Woz4tetra/dodobot-pcb/Dodobot/Dodobot.brd

## EAGLE design Dodobot/Dodobot.brd (2020-08-03)

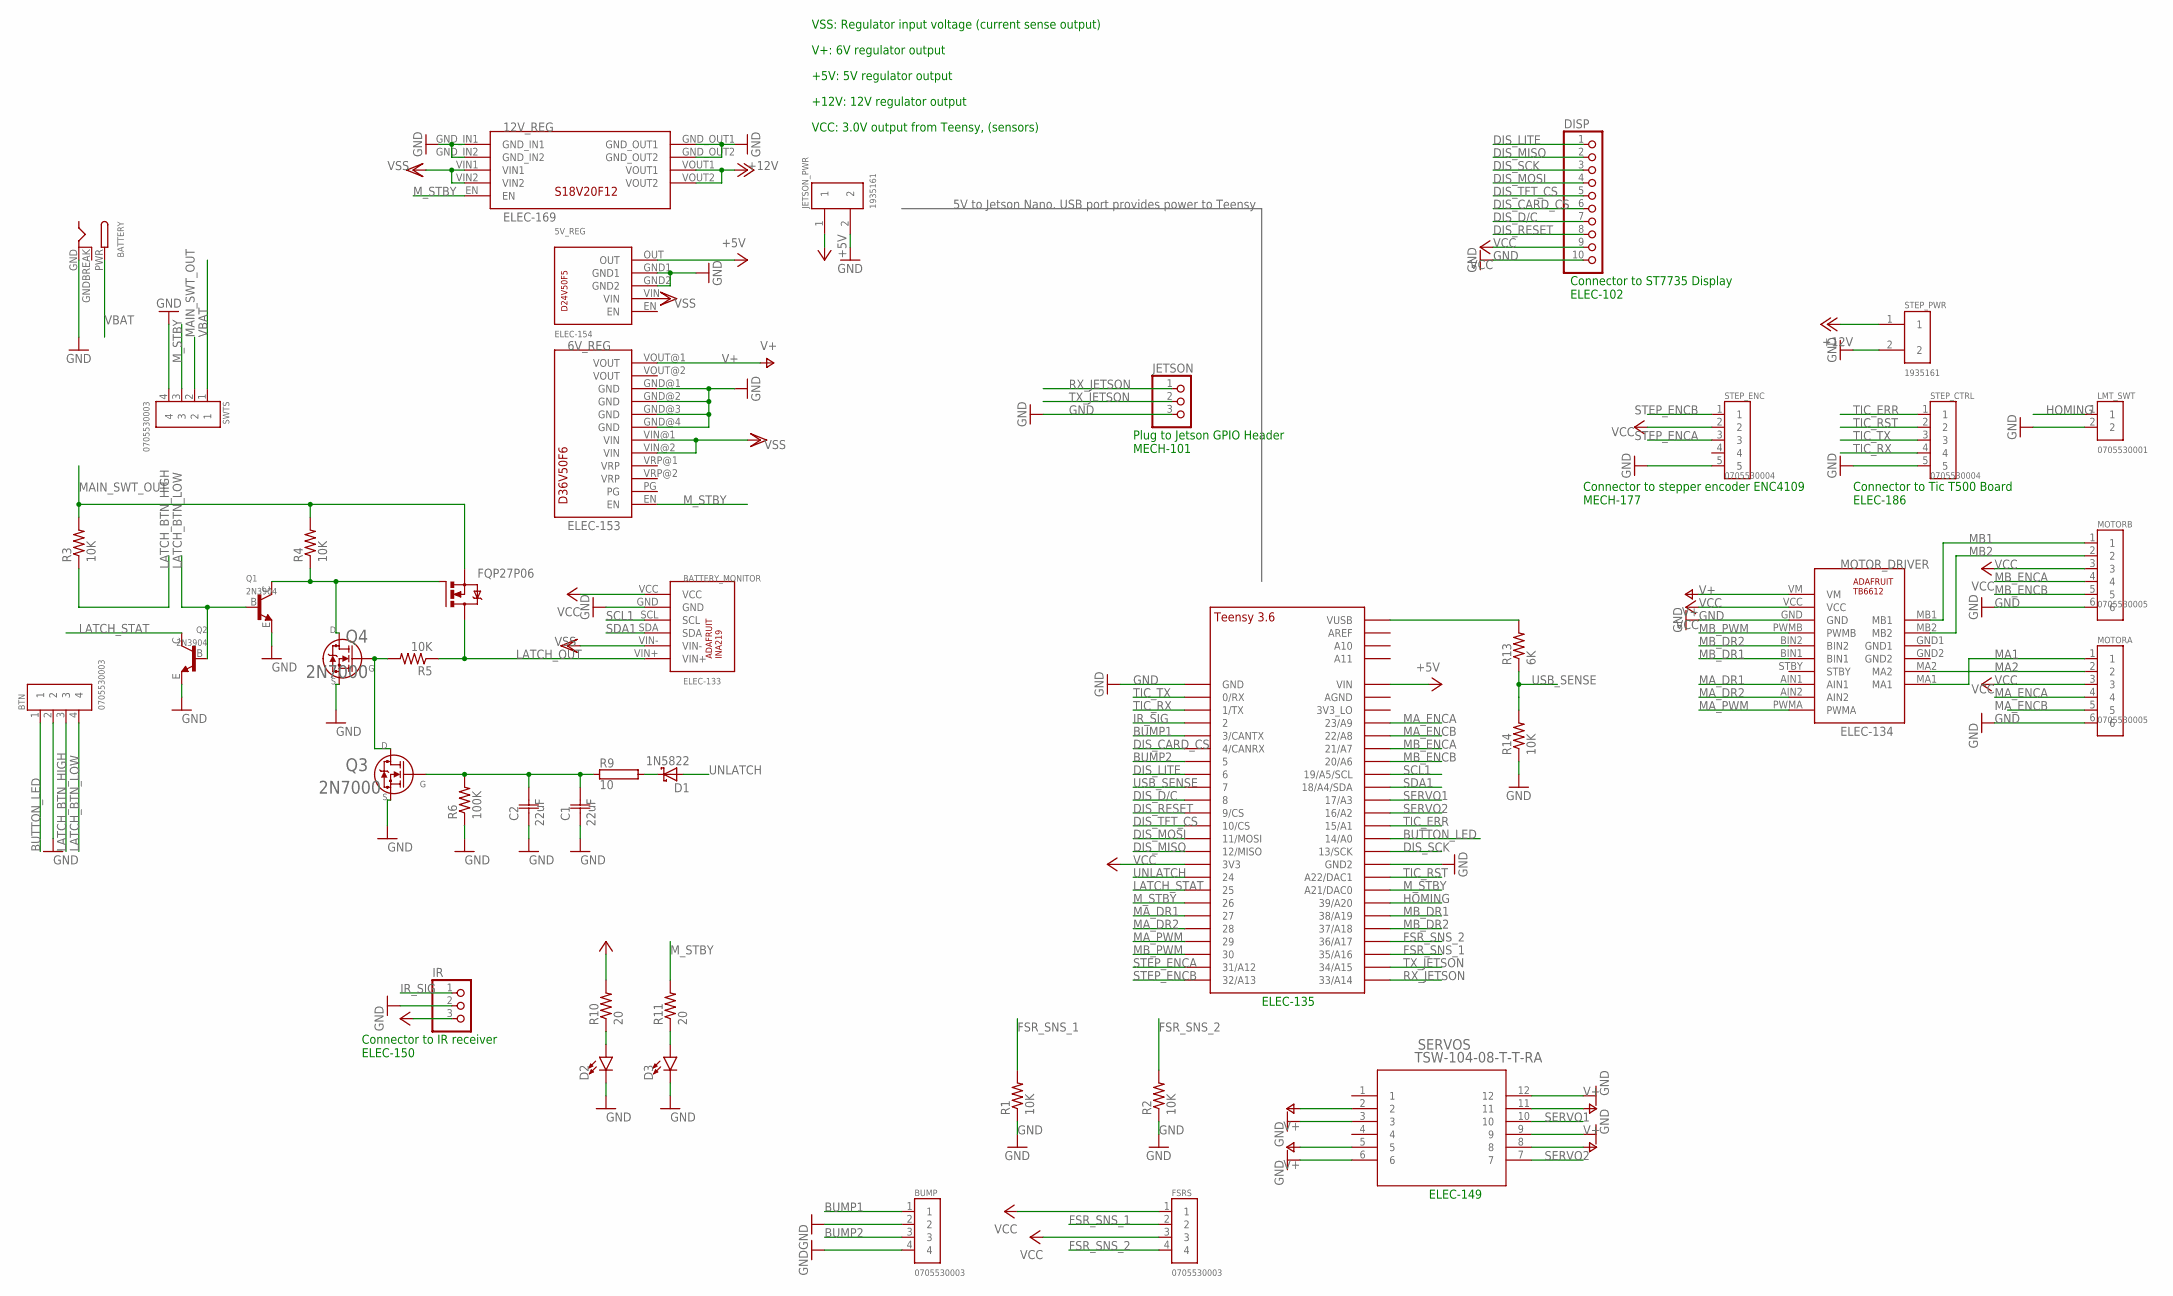
[picture p1: schematic Dodobot.sch]

Parts:
5V_REG: ELEC-154; D24V50F5
6V_REG: ELEC-153; D36V50FX
12V_REG: ELEC-169; S18V20FX
BATTERY: DCBARRELPTH; DCJACK_2MM_PTH
BATTERY_MONITOR: ELEC-133; INA219
BTN: 0705530003; MOLEX_0705530003
BUMP: 0705530003; MOLEX_0705530003
C1, C2: 22uF; CAP_R4525B
D1: 1N5822; DIOAD2120W130L950D530P
D2, D3: LED1206; LED-1206
DISP: PINHD-1X10; 1X10
FQP27P06: IRF530; TO220BV
FSRS: 0705530003; MOLEX_0705530003
IR: PINHD-1X3; 1X03
JETSON: PINHD-1X3; 1X03
JETSON_PWR: 1935161; PHOENIX_1935161
LMT_SWT: 0705530001; MOLEX_0705530001
MOTORA: 0705530005; MOLEX_0705530005
MOTORB: 0705530005; MOLEX_0705530005
MOTOR_DRIVER: ELEC-134; ADAFRUIT_TB6612
Q1, Q2: 2N3904; TO92
Q3, Q4: 2N7000; TO-92
R1, R2, R3, R4, R5, R14: 10K; RES_0805
R6: 100K; RES_0805
R9: 10; HPS58
R10, R11: 20; RES_1206
R13: 6K; RES_0805
SERVOS: TSW-104-08-T-T-RA; TSW-104-08-T-T-RA_SAI
STEP_CTRL: 0705530004; MOLEX_0705530004
STEP_ENC: 0705530004; MOLEX_0705530004
STEP_PWR: 1935161; PHOENIX_1935161
SWTS: 0705530003; MOLEX_0705530003
U$1: TEENSY_3.5/3.6_BASIC

Connections:
+5V: 5V_REG.OUT, JETSON_PWR.1, U$1.VIN
+12V: 12V_REG.VOUT1, 12V_REG.VOUT2, STEP_PWR.1
BUMP1: BUMP.1, U$1.3/CANTX
BUMP2: BUMP.3, U$1.5
BUTTON_LED: BTN.1, U$1.14/A0
DIS_CARD_CS: DISP.6, U$1.4/CANRX
DIS_D/C: DISP.7, U$1.8
DIS_LITE: DISP.1, U$1.6
DIS_MISO: DISP.2, U$1.12/MISO
DIS_MOSI: DISP.4, U$1.11/MOSI
DIS_RESET: DISP.8, U$1.9/CS
DIS_SCK: DISP.3, U$1.13/SCK
DIS_TFT_CS: DISP.5, U$1.10/CS
FSR_SNS_1: FSRS.2, R1.2, U$1.35/A16
FSR_SNS_2: FSRS.4, R2.2, U$1.36/A17
GND: 5V_REG.GND1, 5V_REG.GND2, 6V_REG.GND@1 (GND), 6V_REG.GND@2 (GND), 6V_REG.GND@3 (GND), 6V_REG.GND@4 (GND), 12V_REG.GND_IN1, 12V_REG.GND_IN2, 12V_REG.GND_OUT1, 12V_REG.GND_OUT2, BATTERY.GND, BATTERY_MONITOR.GND, BTN.2, BUMP.2, BUMP.4, C1.1, C2.1, D2.C, D3.C, DISP.10, IR.2, JETSON.3, JETSON_PWR.2, LMT_SWT.2, MOTORA.6, MOTORB.6, MOTOR_DRIVER.GND, Q1.E, Q2.E, Q3.1 (3), Q4.1 (3), R1.1, R2.1, R6.1, R14.1, SERVOS.3, SERVOS.6, SERVOS.9, SERVOS.12, STEP_CTRL.5, STEP_ENC.5, STEP_PWR.2, SWTS.4, U$1.GND, U$1.GND2
GNDBREAK: BATTERY.GNDBREAK
HOMING: LMT_SWT.1, U$1.39/A20
IR_SIG: IR.1, U$1.2
LATCH_BTN_HIGH: BTN.3, R3.1
LATCH_BTN_LOW: BTN.4, Q1.B, Q2.B
LATCH_OUT: BATTERY_MONITOR.VIN+, FQP27P06.D, R5.1
LATCH_STAT: Q2.C, U$1.25
MA1: MOTORA.1, MOTOR_DRIVER.MA1
MA2: MOTORA.2, MOTOR_DRIVER.MA2
MAIN_SWT_OUT: FQP27P06.S, R3.2, R4.2, SWTS.2
MA_DR1: MOTOR_DRIVER.AIN1, U$1.27
MA_DR2: MOTOR_DRIVER.AIN2, U$1.28
MA_ENCA: MOTORA.4, U$1.23/A9
MA_ENCB: MOTORA.5, U$1.22/A8
MA_PWM: MOTOR_DRIVER.PWMA, U$1.29
MB1: MOTORB.1, MOTOR_DRIVER.MB1
MB2: MOTORB.2, MOTOR_DRIVER.MB2
MB_DR1: MOTOR_DRIVER.BIN1, U$1.38/A19
MB_DR2: MOTOR_DRIVER.BIN2, U$1.37/A18
MB_ENCA: MOTORB.4, U$1.21/A7
MB_ENCB: MOTORB.5, U$1.20/A6
MB_PWM: MOTOR_DRIVER.PWMB, U$1.30
M_STBY: 6V_REG.EN, 12V_REG.EN, R11.2, SWTS.3, U$1.21/DAC0 (A21/DAC0), U$1.26
unnamed: D2.A, R10.1
unnamed: D3.A, R11.1
unnamed: FQP27P06.G, Q1.C, Q4.3 (2), R4.1
unnamed: Q3.3 (2), Q4.2 (1), R5.2
unnamed: D1.C, R9.2
unnamed: C1.2, C2.2, Q3.2 (1), R6.2, R9.1
unnamed: R13.2, U$1.VUSB
RX_JETSON: JETSON.1, U$1.33/A14
SCL1: BATTERY_MONITOR.SCL, U$1.19/A5/SCL
SDA1: BATTERY_MONITOR.SDA, U$1.18/A4/SDA
SERVO1: SERVOS.10, U$1.17/A3
SERVO2: SERVOS.7, U$1.16/A2
STEP_ENCA: STEP_ENC.3, U$1.31/A12
STEP_ENCB: STEP_ENC.1, U$1.32/A13
TIC_ERR: STEP_CTRL.1, U$1.15/A1
TIC_RST: STEP_CTRL.2, U$1.A22/DAC1
TIC_RX: STEP_CTRL.4, U$1.1/TX
TIC_TX: STEP_CTRL.3, U$1.0/RX
TX_JETSON: JETSON.2, U$1.34/A15
UNLATCH: D1.A, U$1.24
USB_SENSE: R13.1, R14.2, U$1.7
V+: 6V_REG.VOUT@1 (VOUT), MOTOR_DRIVER.VM, SERVOS.2, SERVOS.5, SERVOS.8, SERVOS.11
VBAT: BATTERY.PWR, SWTS.1
VCC: BATTERY_MONITOR.VCC, DISP.9, FSRS.1, FSRS.3, IR.3, MOTORA.3, MOTORB.3, MOTOR_DRIVER.VCC, R10.2, STEP_ENC.2, U$1.3V3
VSS: 5V_REG.VIN, 6V_REG.VIN@1 (VIN), 6V_REG.VIN@2 (VIN), 12V_REG.VIN1, 12V_REG.VIN2, BATTERY_MONITOR.VIN-

Notes on the sheet:
VSS: Regulator input voltage (current sense output)
V+: 6V regulator output
+12V: 12V regulator output
+5V: 5V regulator output
5V to Jetson Nano. USB port provides power to Teensy
VCC: 3.0V output from Teensy, (sensors)
Plug to Jetson GPIO Header MECH-101
ELEC-135
Connector to ST7735 Display ELEC-102
Connector to Tic T500 Board ELEC-186
Connector to stepper encoder ENC4109 MECH-177
ELEC-149
Connector to IR receiver ELEC-150

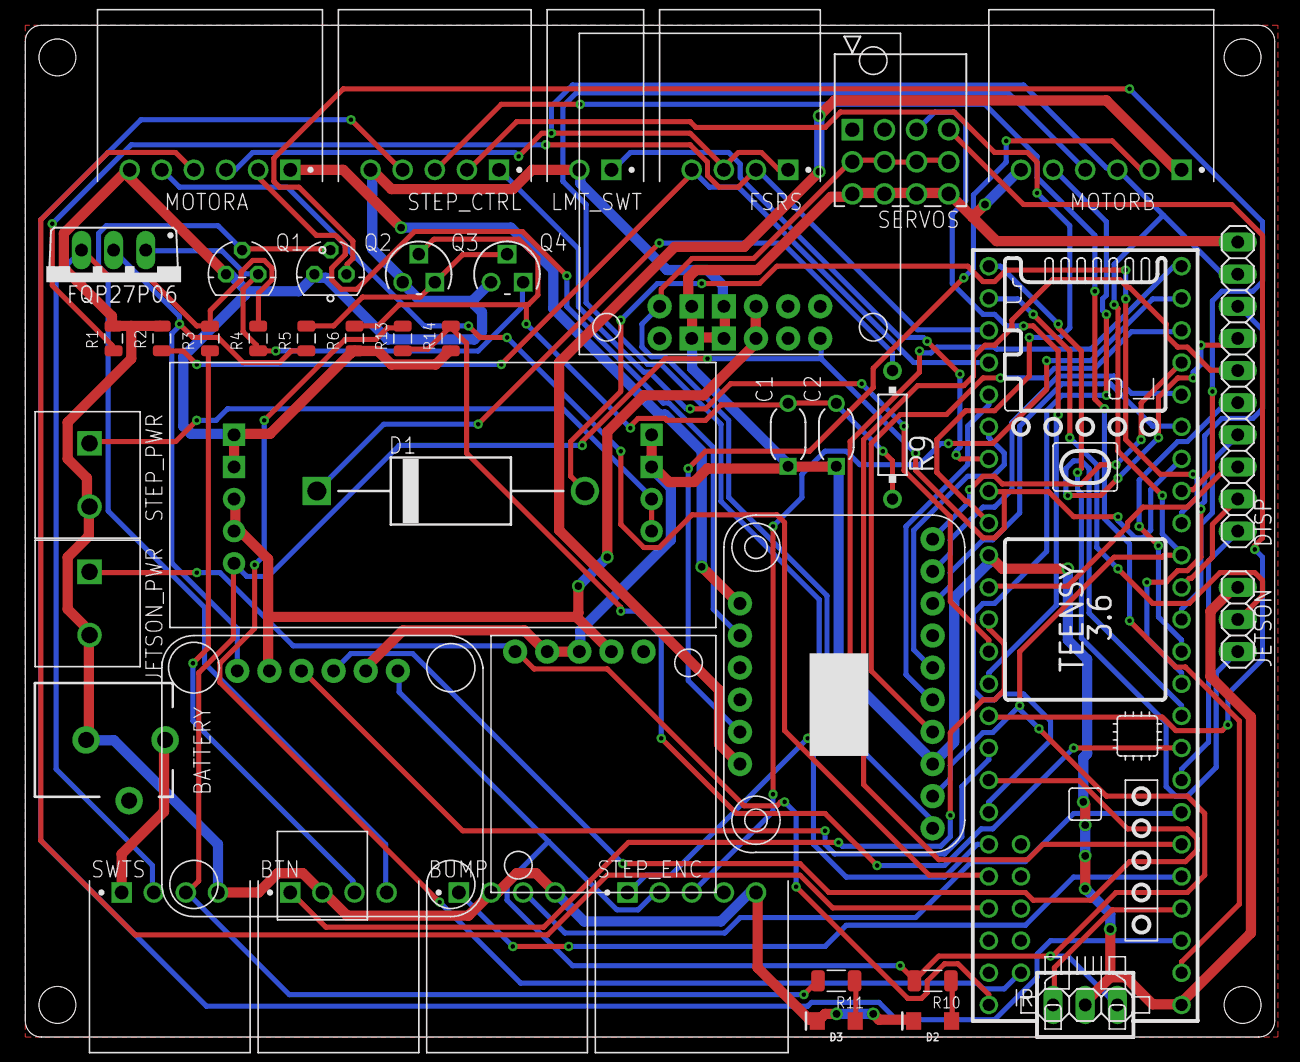
[picture p2: board Dodobot.brd from above]

Board: 2 copper layers, 98.8 x 80.0 mm, 43 parts (0 on the bottom side), 63 nets.
