Woz4tetra/dodobot-pcb/(commit log)

2020-07-23 Rev 1
    [RPi Rover Hat.brd, RPi Rover Hat.sch]
2020-07-23 Restoring Rev 2 changes
    Adding stepper encoder
    Increased tracewidth size
    Added VIN trace to teensy
    changed from 40-pin bus to 3 pin header
    [Dodobot.brd, Dodobot.sch, RPi Rover Hat.brd]
2020-08-01 fixing top connector positioning
    [Dodobot.brd, Dodobot.sch]
2020-08-03 minor fixes. Correcting errors in library files
    [Dodobot.brd, Dodobot.sch]
